St-Evenxiii/Sound-reactive-wall-/sound_reactive_wall.kicad_sch

## KiCad design sound_reactive_wall.kicad_sch (2026-11-03)

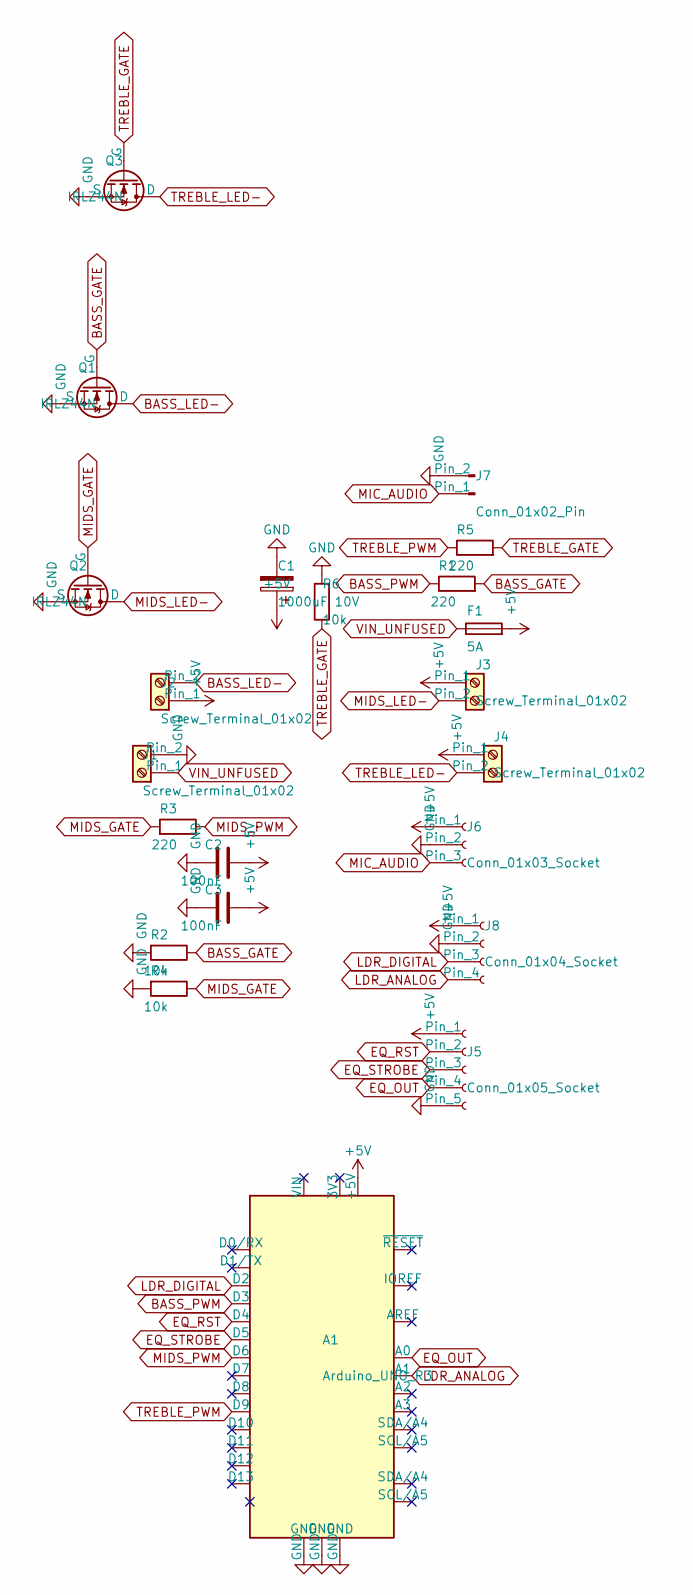
[picture p1: schematic sound_reactive_wall.kicad_sch]

Parts:
A1: Arduino_UNO_R3
C1: 1000uF 10V; CP_Radial_D10.0mm_P5.00mm
C2, C3: 100nF; C_Disc_D5.0mm_W2.5mm_P5.00mm
F1: 5A; Fuseholder_Clip-5x20mm_Keystone_3517_Inline_P23.11x6.76mm_D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
J1, J2, J3, J4: Screw_Terminal_01x02; TerminalBlock_Phoenix_MKDS-1,5-2-5.08_1x02_P5.08mm_Horizont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
J5: Conn_01x05_Socket; PinSocket_1x05_P2.54mm_Vertical
J6: Conn_01x03_Socket; PinSocket_1x03_P2.54mm_Vertical
J7: Conn_01x02_Pin; PinHeader_1x02_P2.54mm_Vertical
J8: Conn_01x04_Socket; PinSocket_1x04_P2.54mm_Vertical
Q1, Q2, Q3: IRLZ44N; TO-220-3_Vertical
R1, R3, R5: 220; R_Axial_DIN0207_L6.3mm_D2.5mm_P10.16mm_Horizontal
R2, R4, R6: 10k; R_Axial_DIN0207_L6.3mm_D2.5mm_P10.16mm_Horizontal

Connections:
+5V: A1.5 (+5V), C1.1, C2.1, C3.1, F1.2, J2.1, J3.1, J4.1, J5.1, J6.1, J8.1
BASS_GATE: Q1.1 (G), R1.2, R2.1
BASS_LED-: J2.2, Q1.2 (D)
BASS_PWM: A1.18 (D3), R1.1
EQ_OUT: A1.9 (A0), J5.4
EQ_RST: A1.19 (D4), J5.2
EQ_STROBE: A1.20 (D5), J5.3
GND: A1.6 (GND), A1.7 (GND), A1.29 (GND), C1.2, C2.2, C3.2, J1.2, J5.5, J6.2, J7.2, J8.2, Q1.3 (S), Q2.3 (S), Q3.3 (S), R2.2, R4.2, R6.2
LDR_ANALOG: A1.10 (A1), J8.4
LDR_DIGITAL: A1.17 (D2), J8.3
MIC_AUDIO: J6.3, J7.1
MIDS_GATE: Q2.1 (G), R3.2, R4.1
MIDS_LED-: J3.2, Q2.2 (D)
MIDS_PWM: A1.21 (D6), R3.1
TREBLE_GATE: Q3.1 (G), R5.2, R6.1
TREBLE_LED-: J4.2, Q3.2 (D)
TREBLE_PWM: A1.24 (D9), R5.1
VIN_UNFUSED: F1.1, J1.1
