St-Evenxiii/Sound-reactive-wall-/(commit log)

2026-08-13 Add SKiDL script and generated KiCad schematic for wall feature PCB
    [sound_reactive_wall.kicad_sch]
2026-11-03 Fix and test the sound-reactive wall PCB description
    Bugs fixed:
    - Schematic generation silently failed with current SKiDL (auto-router
    RoutingFailure on GND/+5V, swallowed with an empty message). All nets are
    now drawn as labels and generation succeeds; output pinned to the KiCad 7+
    format.
    - Symbol library path was appended only to SKiDL's `KICAD` alias, which
    points at a different KiCad version in newer SKiDL, so libraries weren't
    found. Paths now come from KICAD_SYMBOL_DIR or common install locations.
    Circuit improvements:
    - 220R series gate resistors on all three MOSFETs.
    - 5x20mm fuse on the power input and 1000uF bulk cap on the +5V rail.
    - LDR module moved from 3.3V to 5V: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
    [sound_reactive_wall.kicad_sch]
2026-11-03 Add Arduino UNO firmware for the sound-reactive wall
    - MSGEQ7 reader with datasheet timing; 7 bands grouped into bass (D3),
    mids (D6) and treble (D9) PWM channels matching the PCB pin map.
    - Per-channel auto-gain, noise floor, fast-attack/slow-release envelope
    and gamma correction (audio_dsp.h, Arduino-independent).
    - LDR darkness detection with smoothing + hysteresis and a 2 s fade;
    analog or comparator mode, polarity configurable, ALWAYS_ON and
    DEBUG_SERIAL switches for bring-up.
    - Host tests: DSP unit tests plus a full-sketch simulation against a
    mock Arduino API (also checks MSGEQ7 strobe/settle timing).
    - CI: host tests and an arduino:avr:uno compile. README: firmware
    settin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
    [Arduino.h, audio_dsp.h, sound_reactive_wall.ino, test_firmware.cpp]
2026-11-03 CI: compile the sketch with arduino-cli directly
    arduino/compile-sketches@v1 pins Python 3.12.4, which isn't available on
    the current ubuntu-latest image, so the job failed during setup before
    compiling anything. Use setup-arduino-cli and run the compile ourselves.
    Claude-Session: https://claude.ai/code/session_01X84xkzUCskNJFPgQaEGVAt
2026-11-03 README: breadboard bring-up guide; filament resistors are off-board
    Adds a parts list, breadboard wiring table, step-by-step bring-up with
    the firmware's ALWAYS_ON/DEBUG_SERIAL switches, and notes for moving to
    the filaments (external supply, breadboard current limits). Documents
    that each filament's series resistor lives in the wiring off the board.
    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
